CCemons/JammerUsco/3D/Weewooday I2C OLED 0.98” 128x64.step

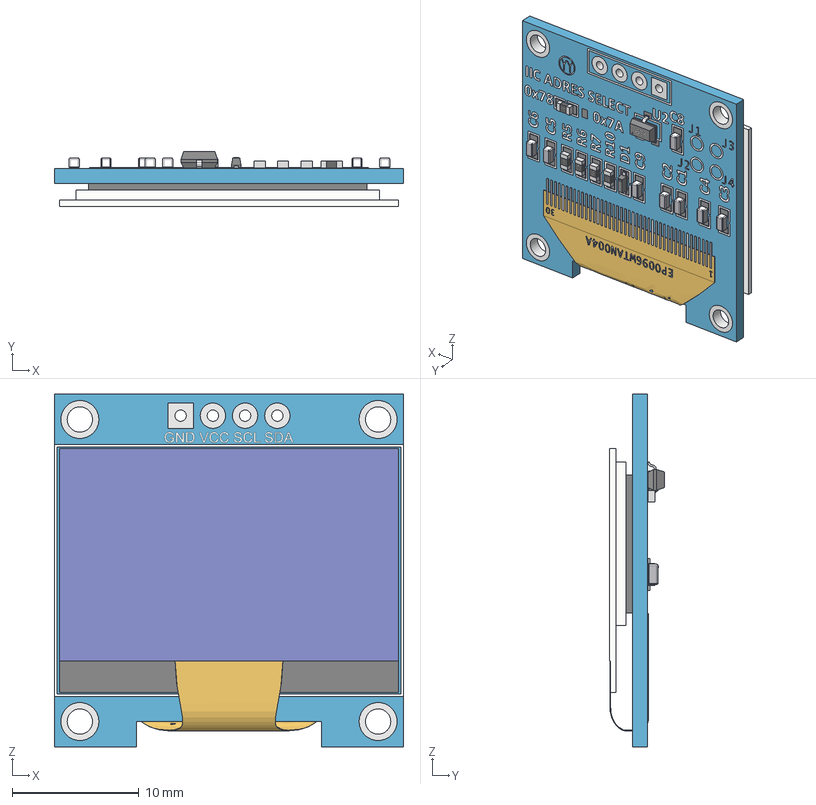
[picture p1: CAD file, 2026-11-08]
3D/Weewooday I2C OLED 0.98” 128x64.step
27.5 x 4.31 x 27.8 mm
pads
silk screen
662k - XC6206P182MR-G:1
R SMD 472:1
R SMD 472:2
R SMD 472:3
R SMD 914:1
R SMD 472:4
C SMD 0603:1
C SMD 0603:2
C SMD 0603:3
C SMD 0603:4
C SMD 0603:5
C SMD 0603:6
C SMD 0603:7
C SMD 0603:8
SOD323F_DIO:1
board:1
screen:1
pins
