CCemons/JammerUsco/3D/JammerUsco_Buttons.step

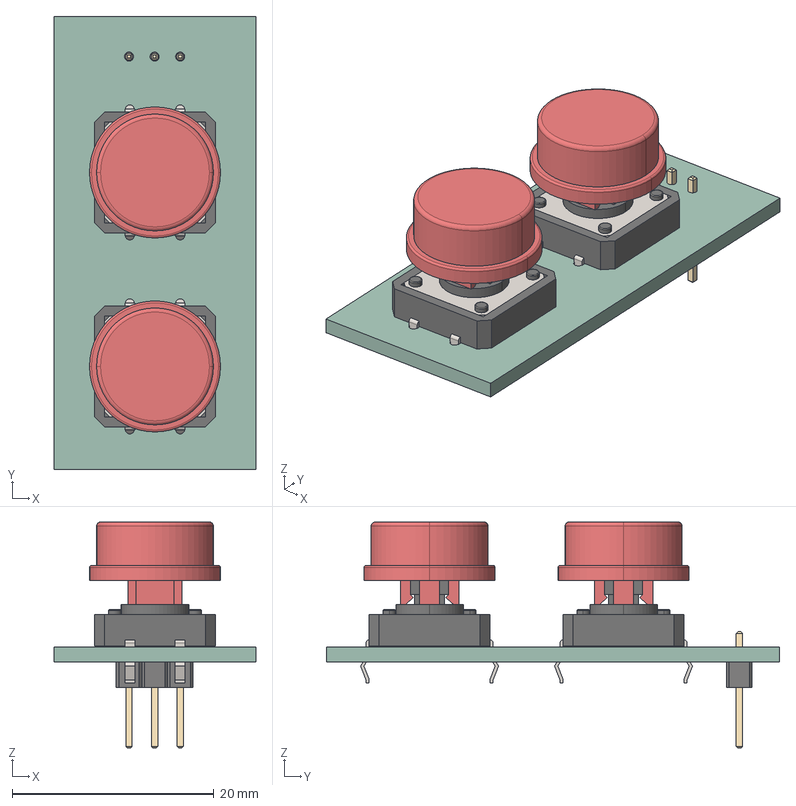
[picture p2: CAD file, 2026-11-08]
3D/JammerUsco_Buttons.step
20.0 x 45.0 x 22.4 mm
PinHeader_1x03_P254mm_Vertical
12mm Push Button x 2
12mm Push Button Cap x 2
JammerUsco_Buttons_PCB
