CCemons/JammerUsco/3D/Fusion_3D_Case_Caja_Mitad_Inferior_EXPORTADO.step

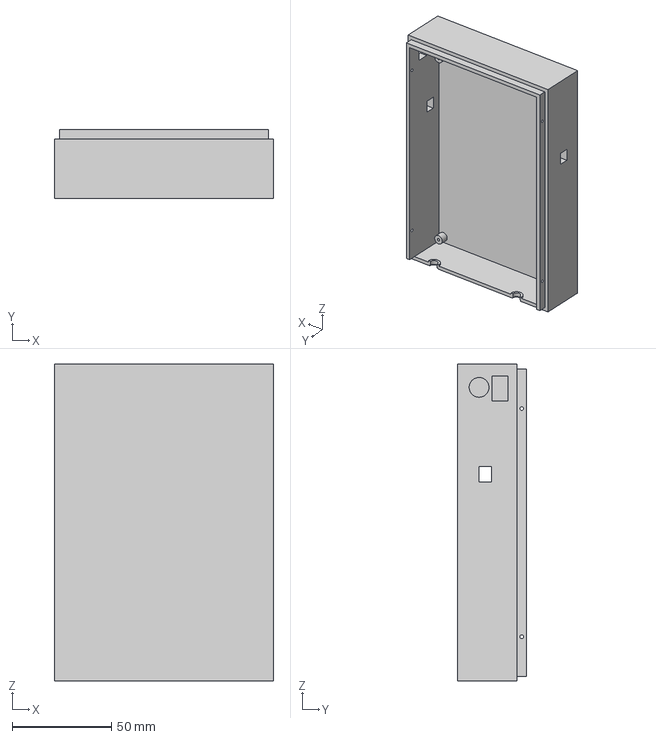
[picture p3: CAD file, 2026-11-08]
3D/Fusion_3D_Case_Caja_Mitad_Inferior_EXPORTADO.step
110.6 x 35.1 x 160.1 mm
