CCemons/JammerUsco/3D/JammerUsco.step

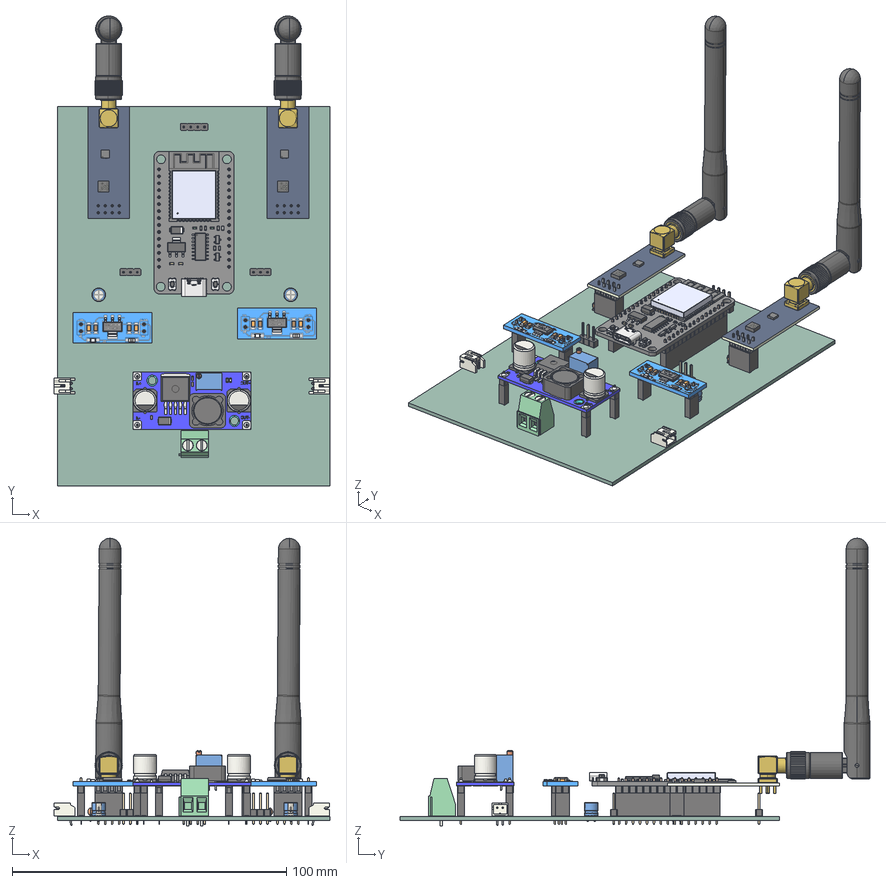
[picture p4: CAD file, 2026-11-08]
3D/JammerUsco.step
100.5 x 171.5 x 104.9 mm
PinSocket_1x15_P2.54mm_Vertical x 2
6130xx11121_PIN x 30
SMA
0603 cap x 2
C&K - KMR7 x 2
0603 resistor x 6
LED 0603 Lens GREEN x 2
LED 0603 Base GREEN x 2
SOT-23-3 x 2
Leader x 16
SOT-223
Notch
Molex
TerminalBlock_Phoenix_MKDS-1,5-2-5.08_1x02_P5.08mm_Horizontal
PinHeader_1x04_P254mm_Vertical
PinSocket_2x04_P2.54mm_Vertical x 2
NRF24L01_PCB x 2
male header x 16
NRF24L01_SMA-angled x 2
NRF24L01-CHIP-NRF___ _________ x 2
User Library-QFN-16_3x3_1 x 2
User Library-QFN-16_3x3_2 x 2
User Library-QFN-16_3x3_3 x 2
User Library-QFN-16_3x3_4 x 2
User Library-QFN-16_3x3_5 x 2
User Library-QFN-16_3x3_6 x 2
User Library-QFN-16_3x3_7 x 2
User Library-QFN-16_3x3_8 x 2
User Library-QFN-16_3x3_9 x 2
User Library-QFN-16_3x3_10 x 2
User Library-QFN-16_3x3_11 x 2
User Library-QFN-16_3x3_12 x 2
User Library-QFN-16_3x3_13 x 2
User Library-QFN-16_3x3_14 x 2
User Library-QFN-16_3x3_15 x 2
User Library-QFN-16_3x3_16 x 2
User Library-QFN-16_3x3_17 x 2
User Library-QFN-16_3x3_18 x 2
Bottom_Radio_Antenna_Dfaut x 2
Top_Radio_Antenna_Dfaut x 2
Screw_Radio_Antenna_Dfaut x 2
Insert_Radio_Antenna_Dfaut x 2
Pin_Radio_Antenna_Dfaut x 4
Wire_Top_Radio_Antenna_Dfaut x 2
Wire_Radio_Antenna_Dfaut x 2
PinSocket_1x02_P2.54mm_Vertical x 4
AMS1117-POWER-PCB x 2
2112-0805-SMT-LED x 2
AMS1117-3-3-POWER-ship-SOT223 x 2
Resitance-102 x 2
Chip-cap-0.1uF-h7-inch0805-metric2012 x 4
Chip-cap-10uF-h10-inch0805-metric2012 x 4
PinHeader_1x02_P254mm_Vertical x 4
CP_Radial_D50mm_P250mm x 2
JST_S2B_PH_K x 2
PinSocket_1x01_P2.54mm_Vertical x 4
C_Elec_8x102
C_Elec_8x103
C_Elec_8x106
C_Elec_8x107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
