CCemons/JammerUsco/PCB/Kicad_Project/JammerUsco/JammerUsco.kicad_pcb

## KiCad design PCB/Kicad_Project/JammerUsco/JammerUsco.kicad_pcb (2026-11-08)

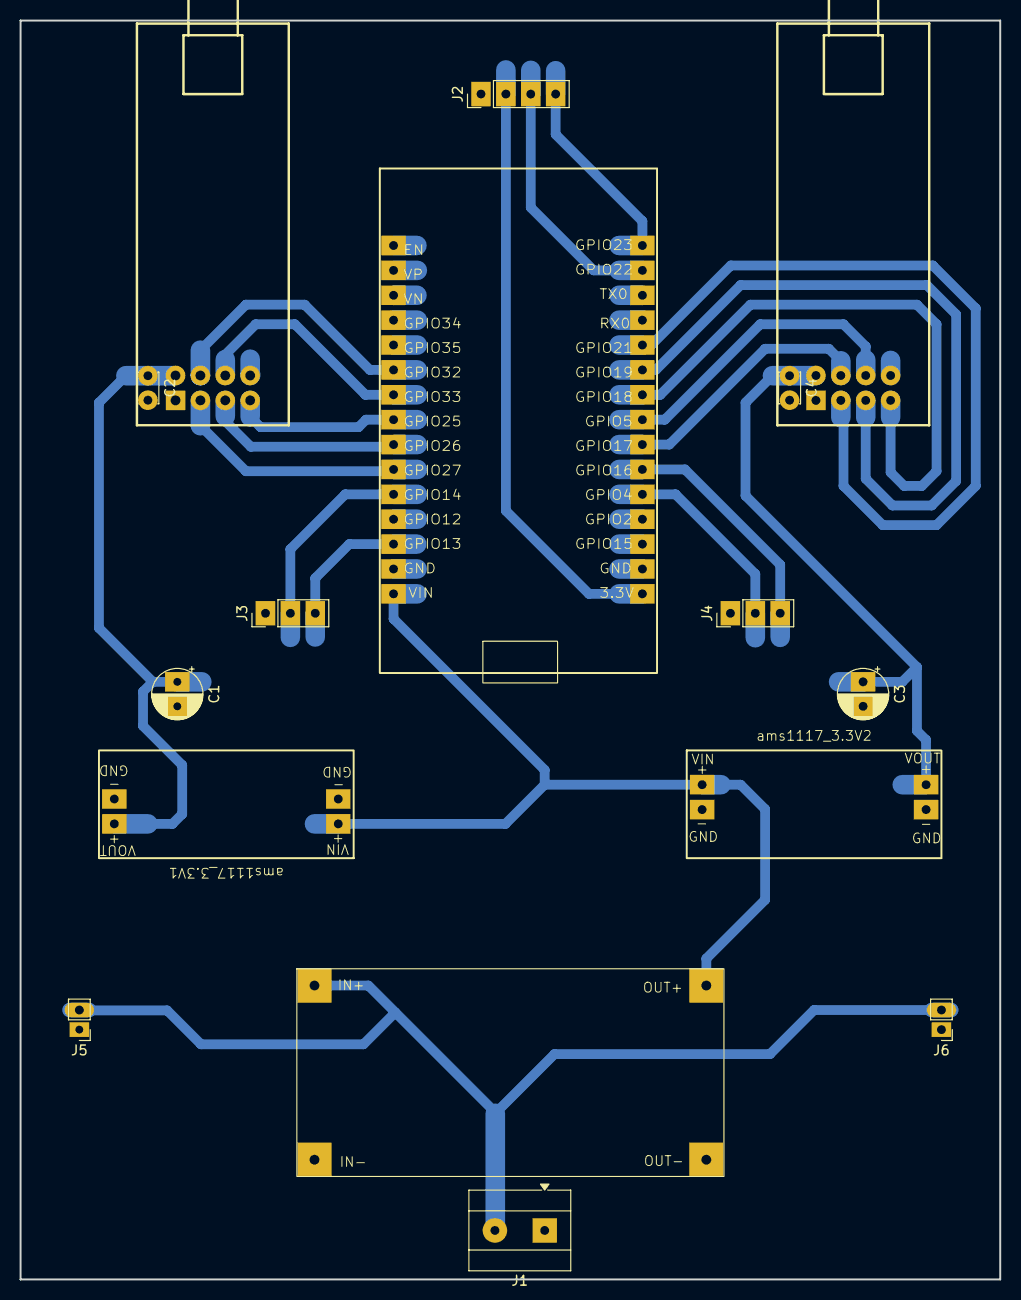
[picture p6: board JammerUsco.kicad_pcb from above]

Board: 2 copper layers, 100.0 x 128.5 mm, 16 parts (0 on the bottom side), 22 nets.

Parts:
C1, C3: C_10uF; CP_Radial_D5.0mm_P2.50mm
C2, C4: C_0.1uF; C_Disc_D3.0mm_W2.0mm_P2.50mm
ESP32_30pin1: ESP32_30pin
J1: 12V; TerminalBlock_MetzConnect_Type101_RT01602HBWC_1x02_P5.08mm_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
J2: Display; PinHeader_1x04_P2.54mm_Vertical
J3: Up_down_btts; PinHeader_1x03_P2.54mm_Vertical
J4: Ok_back_btts; PinHeader_1x03_P2.54mm_Vertical
J5: Amp1; PinHeader_1x02_P2.00mm_Vertical
J6: Amp2; PinHeader_1x02_P2.00mm_Vertical
LM2596_BUCK_MODULE_5V1: LM2596_BUCK_MODULE_5V
NRF24L01+PA+LNA1, NRF24L01+PA+LNA2: NRF24L01_PA_LNA
ams1117_3.3V1, ams1117_3.3V2: ams1117_module_3.3V

Connections:
3.3V R1: C1.1, C2.1, NRF24L01+PA+LNA1.2 (VCC), ams1117_3.3V1.3 (Vout)
3.3V R2: C3.1, C4.1, NRF24L01+PA+LNA2.2 (VCC), ams1117_3.3V2.3 (Vout)
5V: ESP32_30pin1.1 (VIN), LM2596_BUCK_MODULE_5V1.3 (OUT+), ams1117_3.3V1.1 (Vin), ams1117_3.3V2.1 (Vin)
12V: J1.2, J5.2, J6.2, LM2596_BUCK_MODULE_5V1.1 (IN+)
Back btt: ESP32_30pin1.21 (GPIO16), J4.3
CE1: ESP32_30pin1.6 (GPIO27), NRF24L01+PA+LNA1.3 (CE)
CE2: ESP32_30pin1.26 (GPIO21), NRF24L01+PA+LNA2.3 (CE)
CSN1: ESP32_30pin1.10 (GPIO32), NRF24L01+PA+LNA1.4 (CSN)
CSN2: ESP32_30pin1.22 (GPIO17), NRF24L01+PA+LNA2.4 (CSN)
Down btt: ESP32_30pin1.3 (GPIO13), J3.3
ESP32 3.3V: ESP32_30pin1.16 (3.3V), J2.2
GND: C1.2, C2.2, C3.2, C4.2, ESP32_30pin1.2 (GND), ESP32_30pin1.17 (GND), J1.1, J2.1, J3.1, J4.1, J5.1, J6.1, LM2596_BUCK_MODULE_5V1.2 (IN-), LM2596_BUCK_MODULE_5V1.4 (OUT-), NRF24L01+PA+LNA1.1 (GND), NRF24L01+PA+LNA2.1 (GND), ams1117_3.3V1.2 (GND), ams1117_3.3V1.4 (GND), ams1117_3.3V2.2 (GND), ams1117_3.3V2.4 (GND)
MISO1: ESP32_30pin1.8 (GPIO25), NRF24L01+PA+LNA1.7 (MISO)
MISO2: ESP32_30pin1.24 (GPIO18), NRF24L01+PA+LNA2.7 (MISO)
MOSI1: ESP32_30pin1.9 (GPIO33), NRF24L01+PA+LNA1.6 (MOSI)
MOSI2: ESP32_30pin1.23 (GPIO5), NRF24L01+PA+LNA2.6 (MOSI)
Ok btt: ESP32_30pin1.20 (GPIO4), J4.2
SCK1: ESP32_30pin1.7 (GPIO26), NRF24L01+PA+LNA1.5 (SCK)
SCK2: ESP32_30pin1.25 (GPIO19), NRF24L01+PA+LNA2.5 (SCK)
SCL: ESP32_30pin1.29 (GPIO22), J2.3
SDA: ESP32_30pin1.30 (GPIO23), J2.4
Up btt: ESP32_30pin1.5 (GPIO14), J3.2
